AnlogicInfo/referencedesign/README.txt

Reference Design for Anlogic PLD devices.

Copyright 2011-2017 Anlogic Technologies.
