AnlogicInfo/referencedesign/eg4-20/MINI_EG4X20.pdf

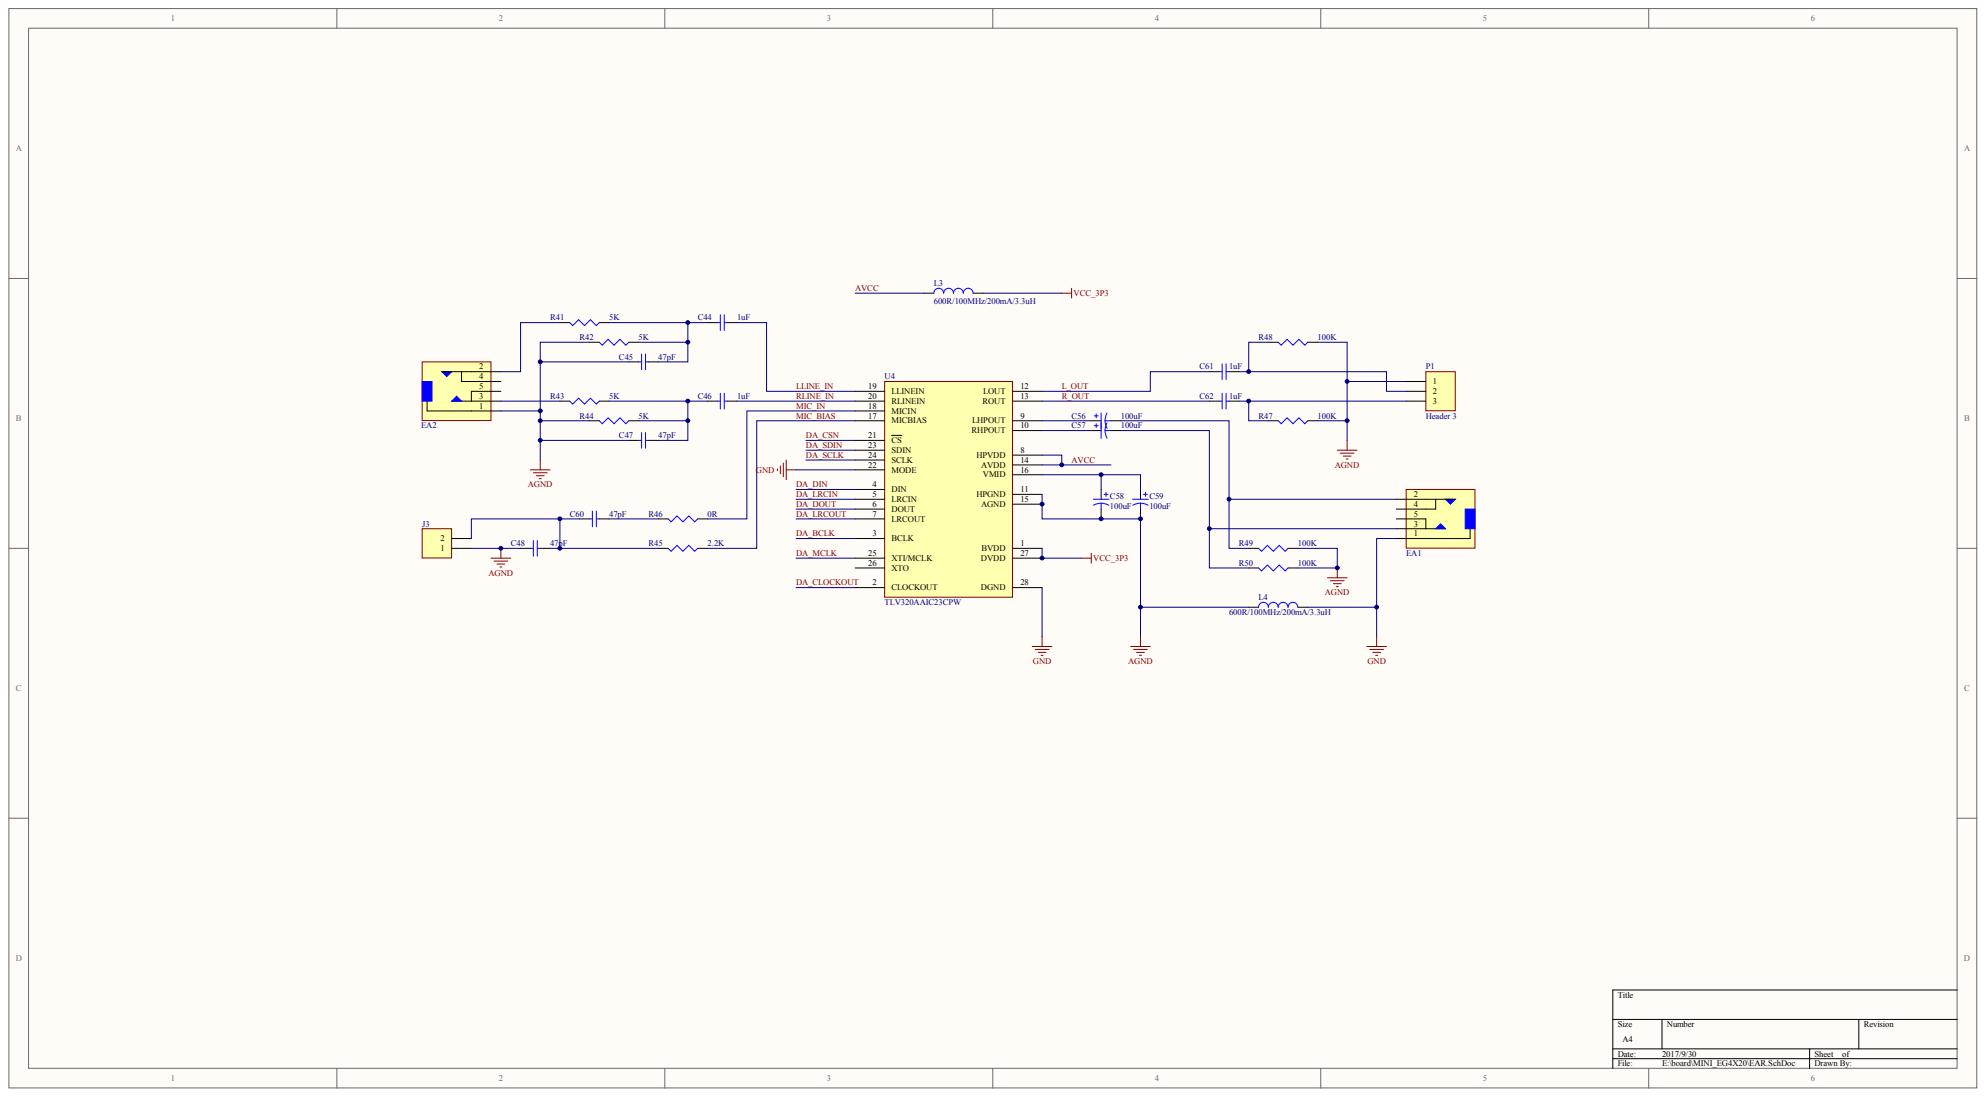
[picture p8: page 1]

1 5 1 2 7 2 8 | VCC_3P | 3 | R49

DA_BCL K 2 . 2 K | 2 6

S ize A4 | Number | Rev isi o n

Date: 2017/9/30 | S heet o f
F i le: E : \board\MINI_EG4X20 \ E AR.SchDoc | Drawn B y :

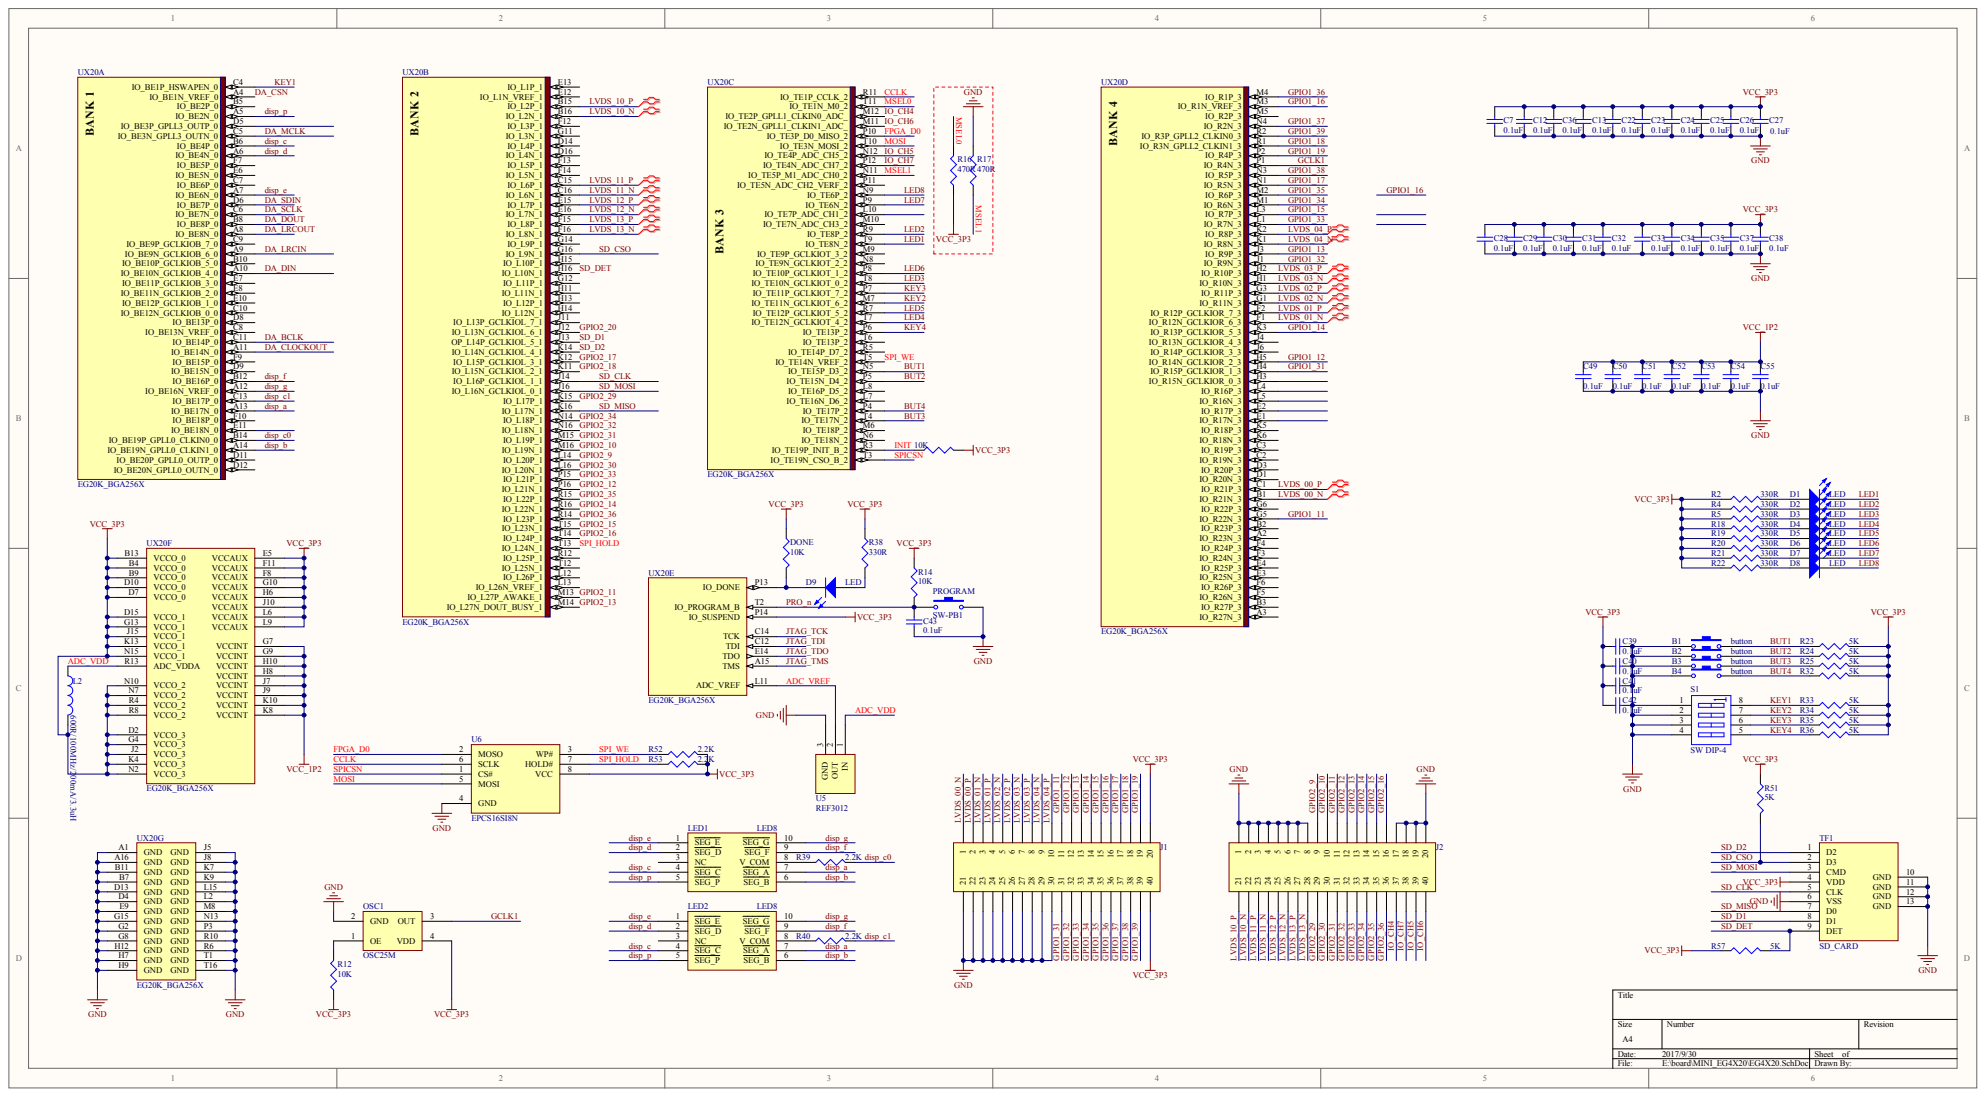
[picture p9: page 2]

Size A4 | Number | Revision

Date: 2017/9/30 | Sheet of
File: E:\board\MINI_EG4X20\EG4X20.SchDoc | Drawn By:

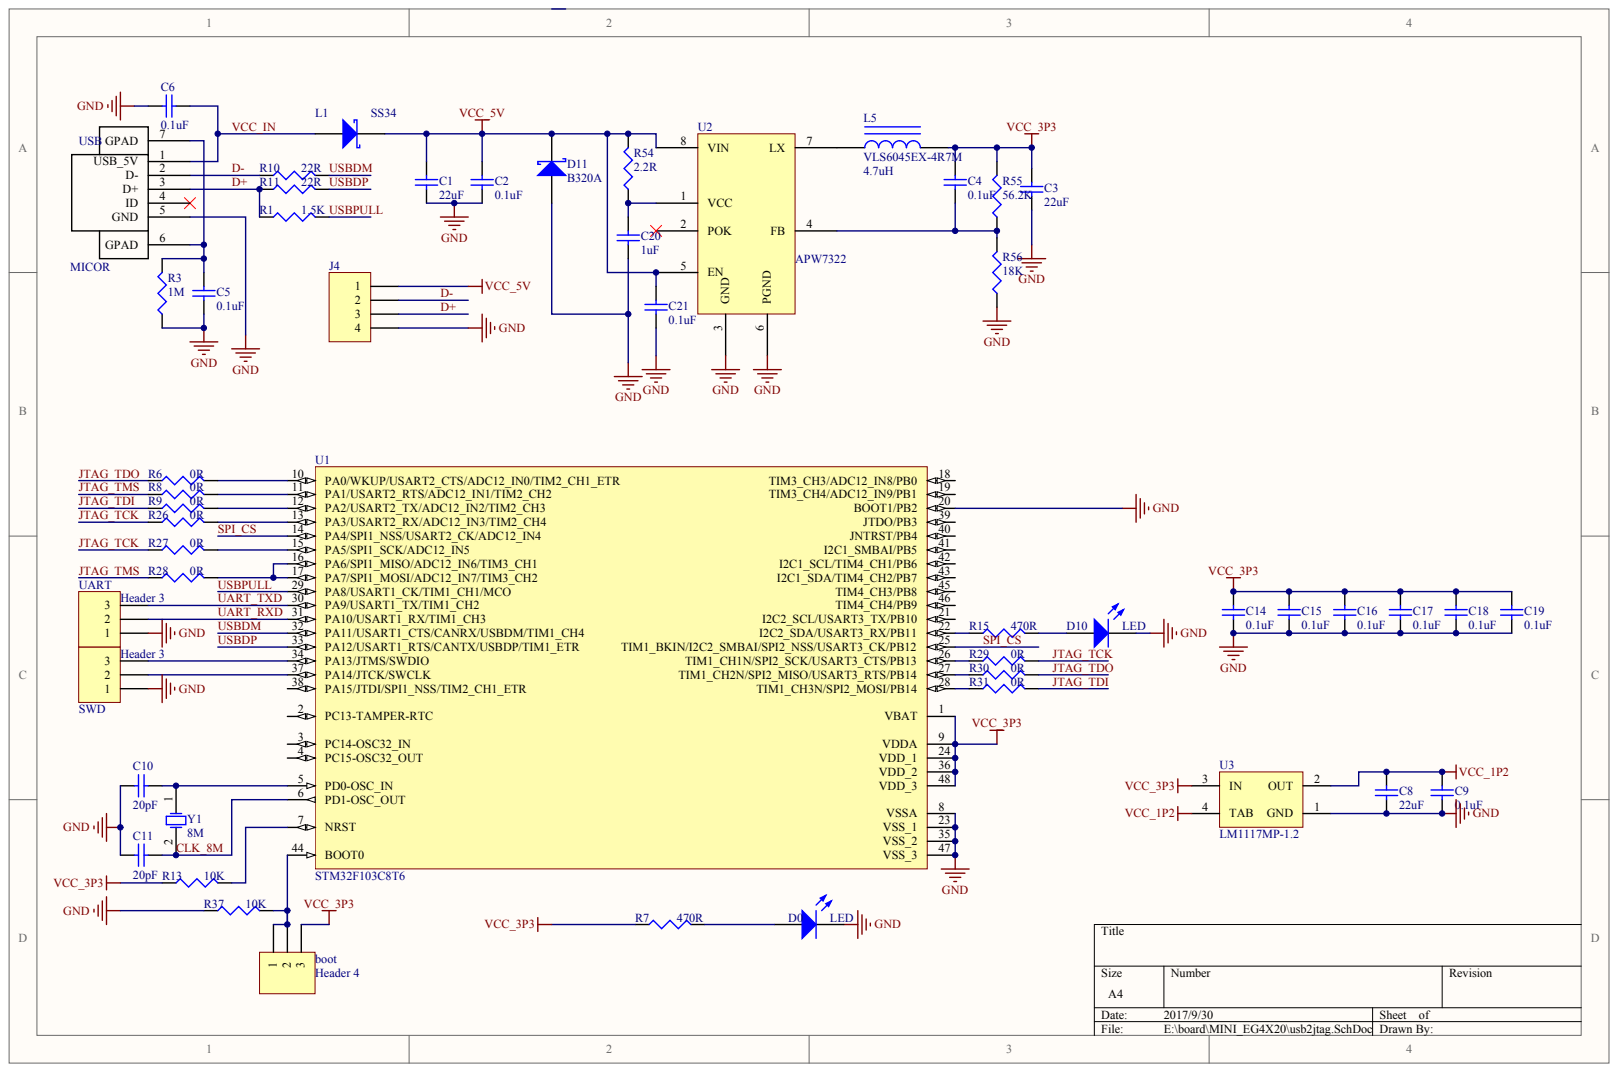
[picture p10: page 3]

PA11/USART1_CTS/CANRX/USBDM/TIM1_CH4 32

Header 3 | USBDP | PA12/USART1_RTS/CANTX/USBDP/TIM1_ETR 33
3 2 1 | | PA13/JTMS/SWDIO 34

PA15/JTDI/SPI1_NSS/TIM2_CH1_ETR 38

PD1-OSC_OUT 6

BOOT0 44

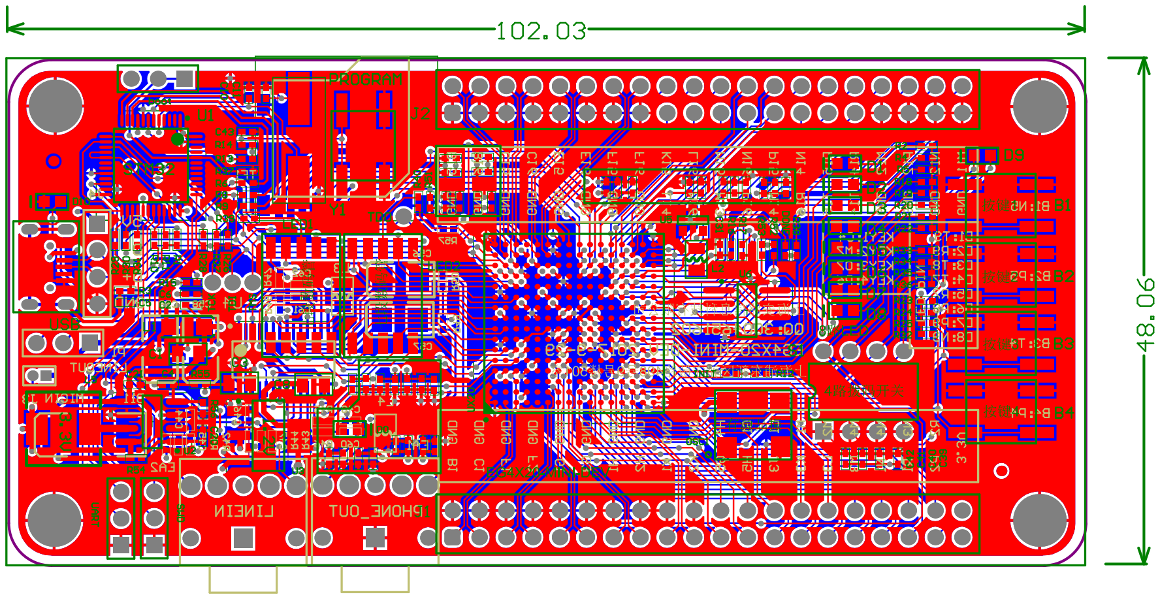
[picture p11: page 4]
