AnlogicInfo/referencedesign/al3/AL3S10LG144_CORE.PDF

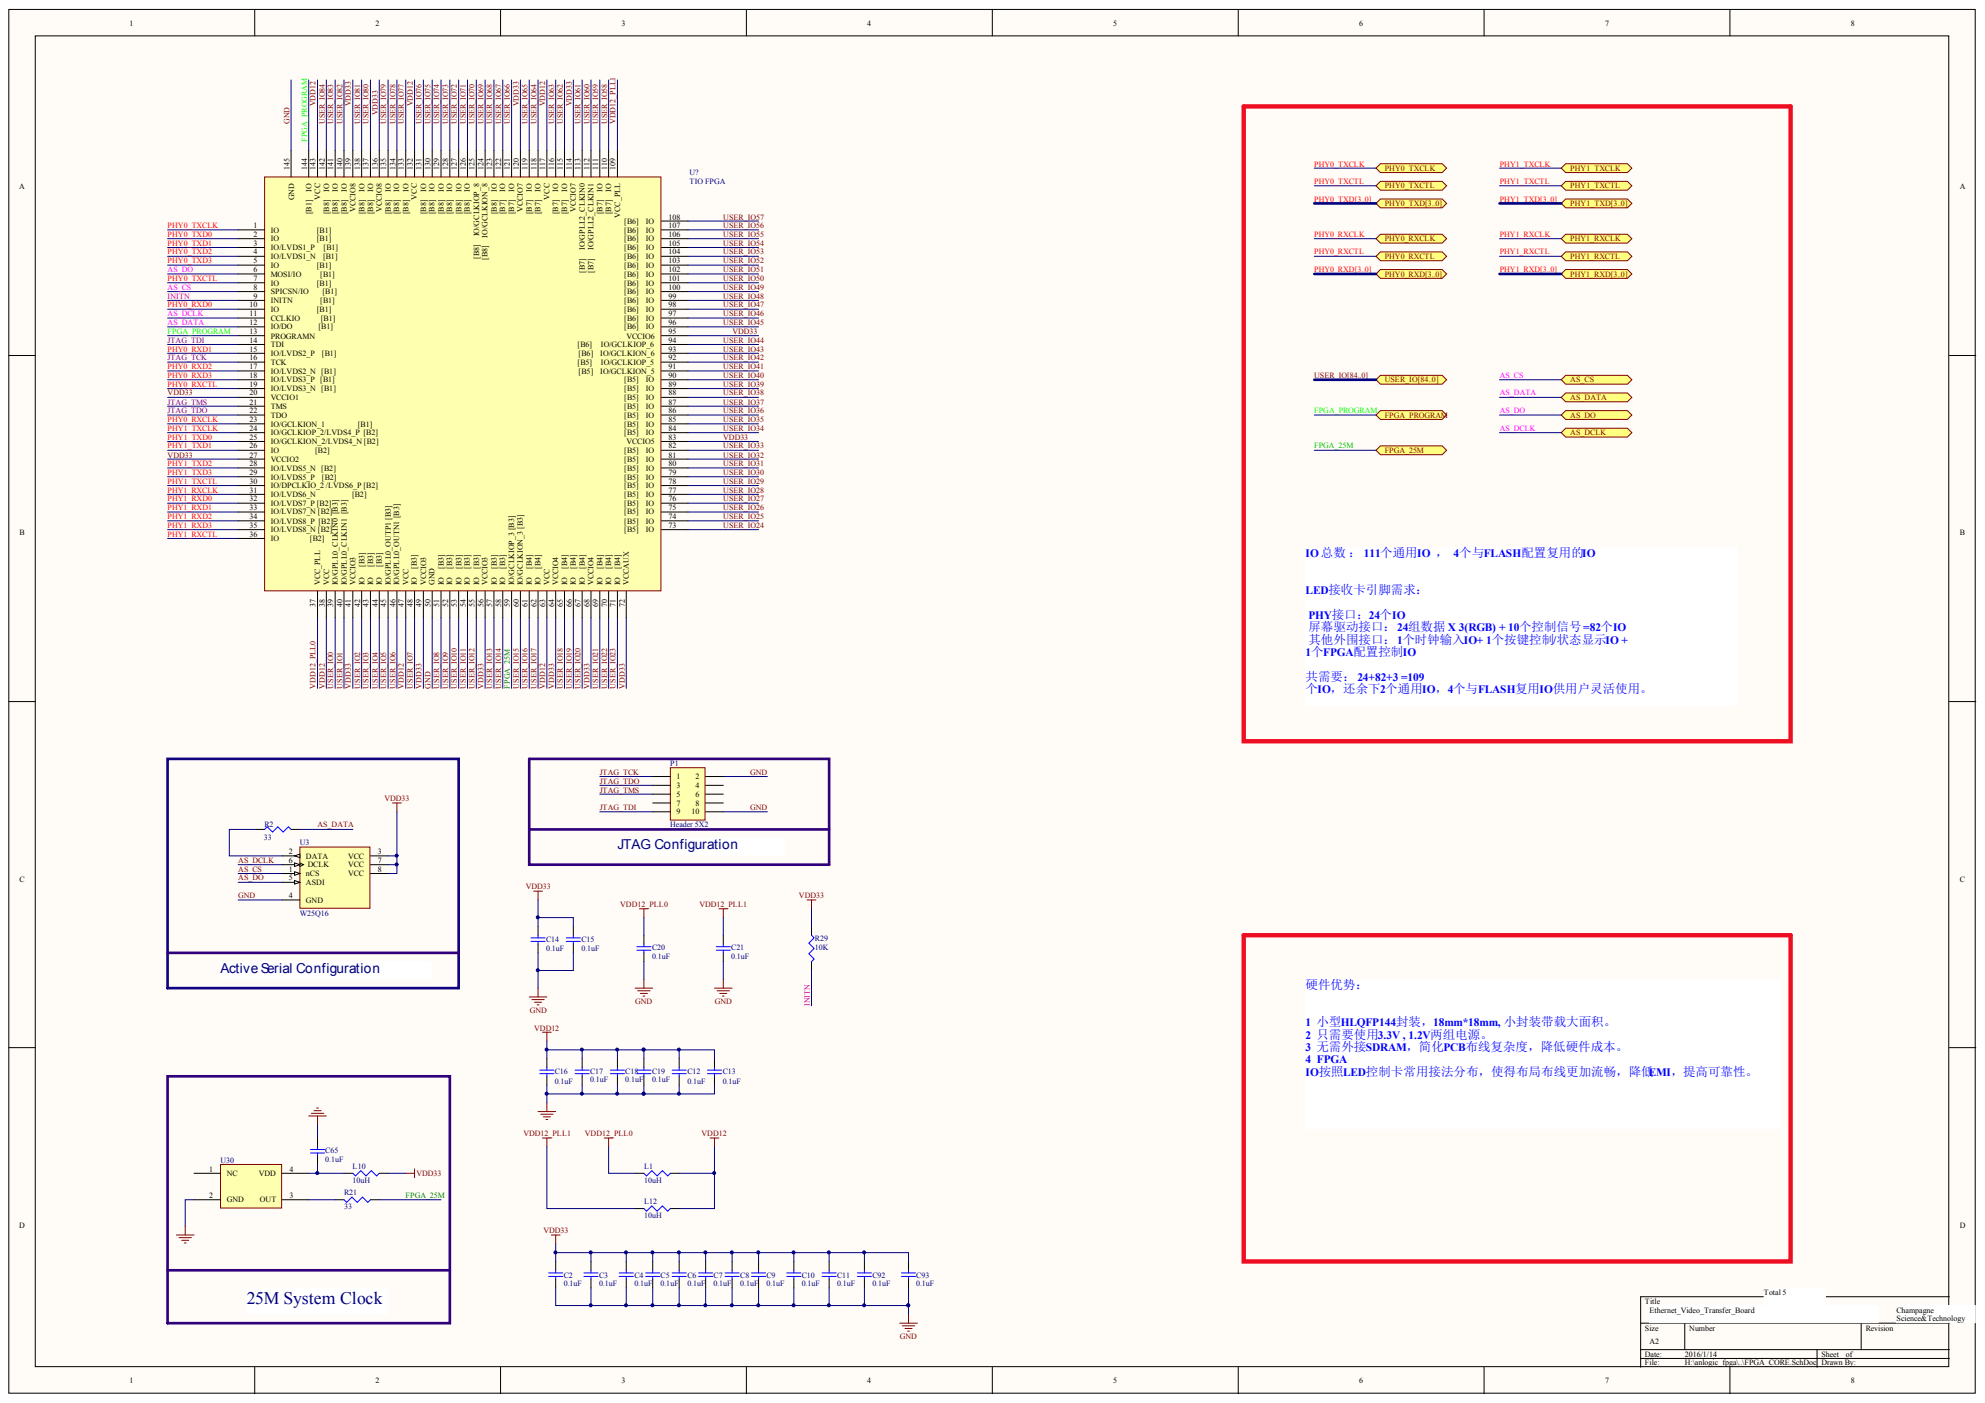
[picture p12: page 1]

[B7] IO/GPLL2_CLKIN0 113 VCCIO7 114 [B7] IO 115 [B7] IO 116 VCC 117 [B7] IO 118 [B7] IO 119 VCCIO7 120 [B7] IO 121 [B7] IO 122 [B8] IO 123 [B8] IO/GCLKION_8 124 [B8] IO/GCLKIOP_8 125 [B8] IO 126 [B8] IO 127 [B8] IO 128 [B8] IO 129 [B8] IO 130 [B8] IO 131 VCC 132 [B8] IO 133 [B8] IO 134 [B8] IO 135 VCCIO8 136 [B8] IO 137 [B8] IO 138 VCCIO8 139

VCCAUX 72 [B5] IO 73 [B5] IO 74 [B5] IO 75

3 无需外接SDRAM，简化PCB布线复杂度，降低硬件成本。 4 FPGA
IO按照LED控制卡常用接法分布，使得布局布线更加流畅，降低EMI，提高可靠性。
