AnlogicInfo/referencedesign/eg4-20/eg4duino_fin.brd

## EAGLE design eg4-20/eg4duino_fin.brd (2018-01-02)

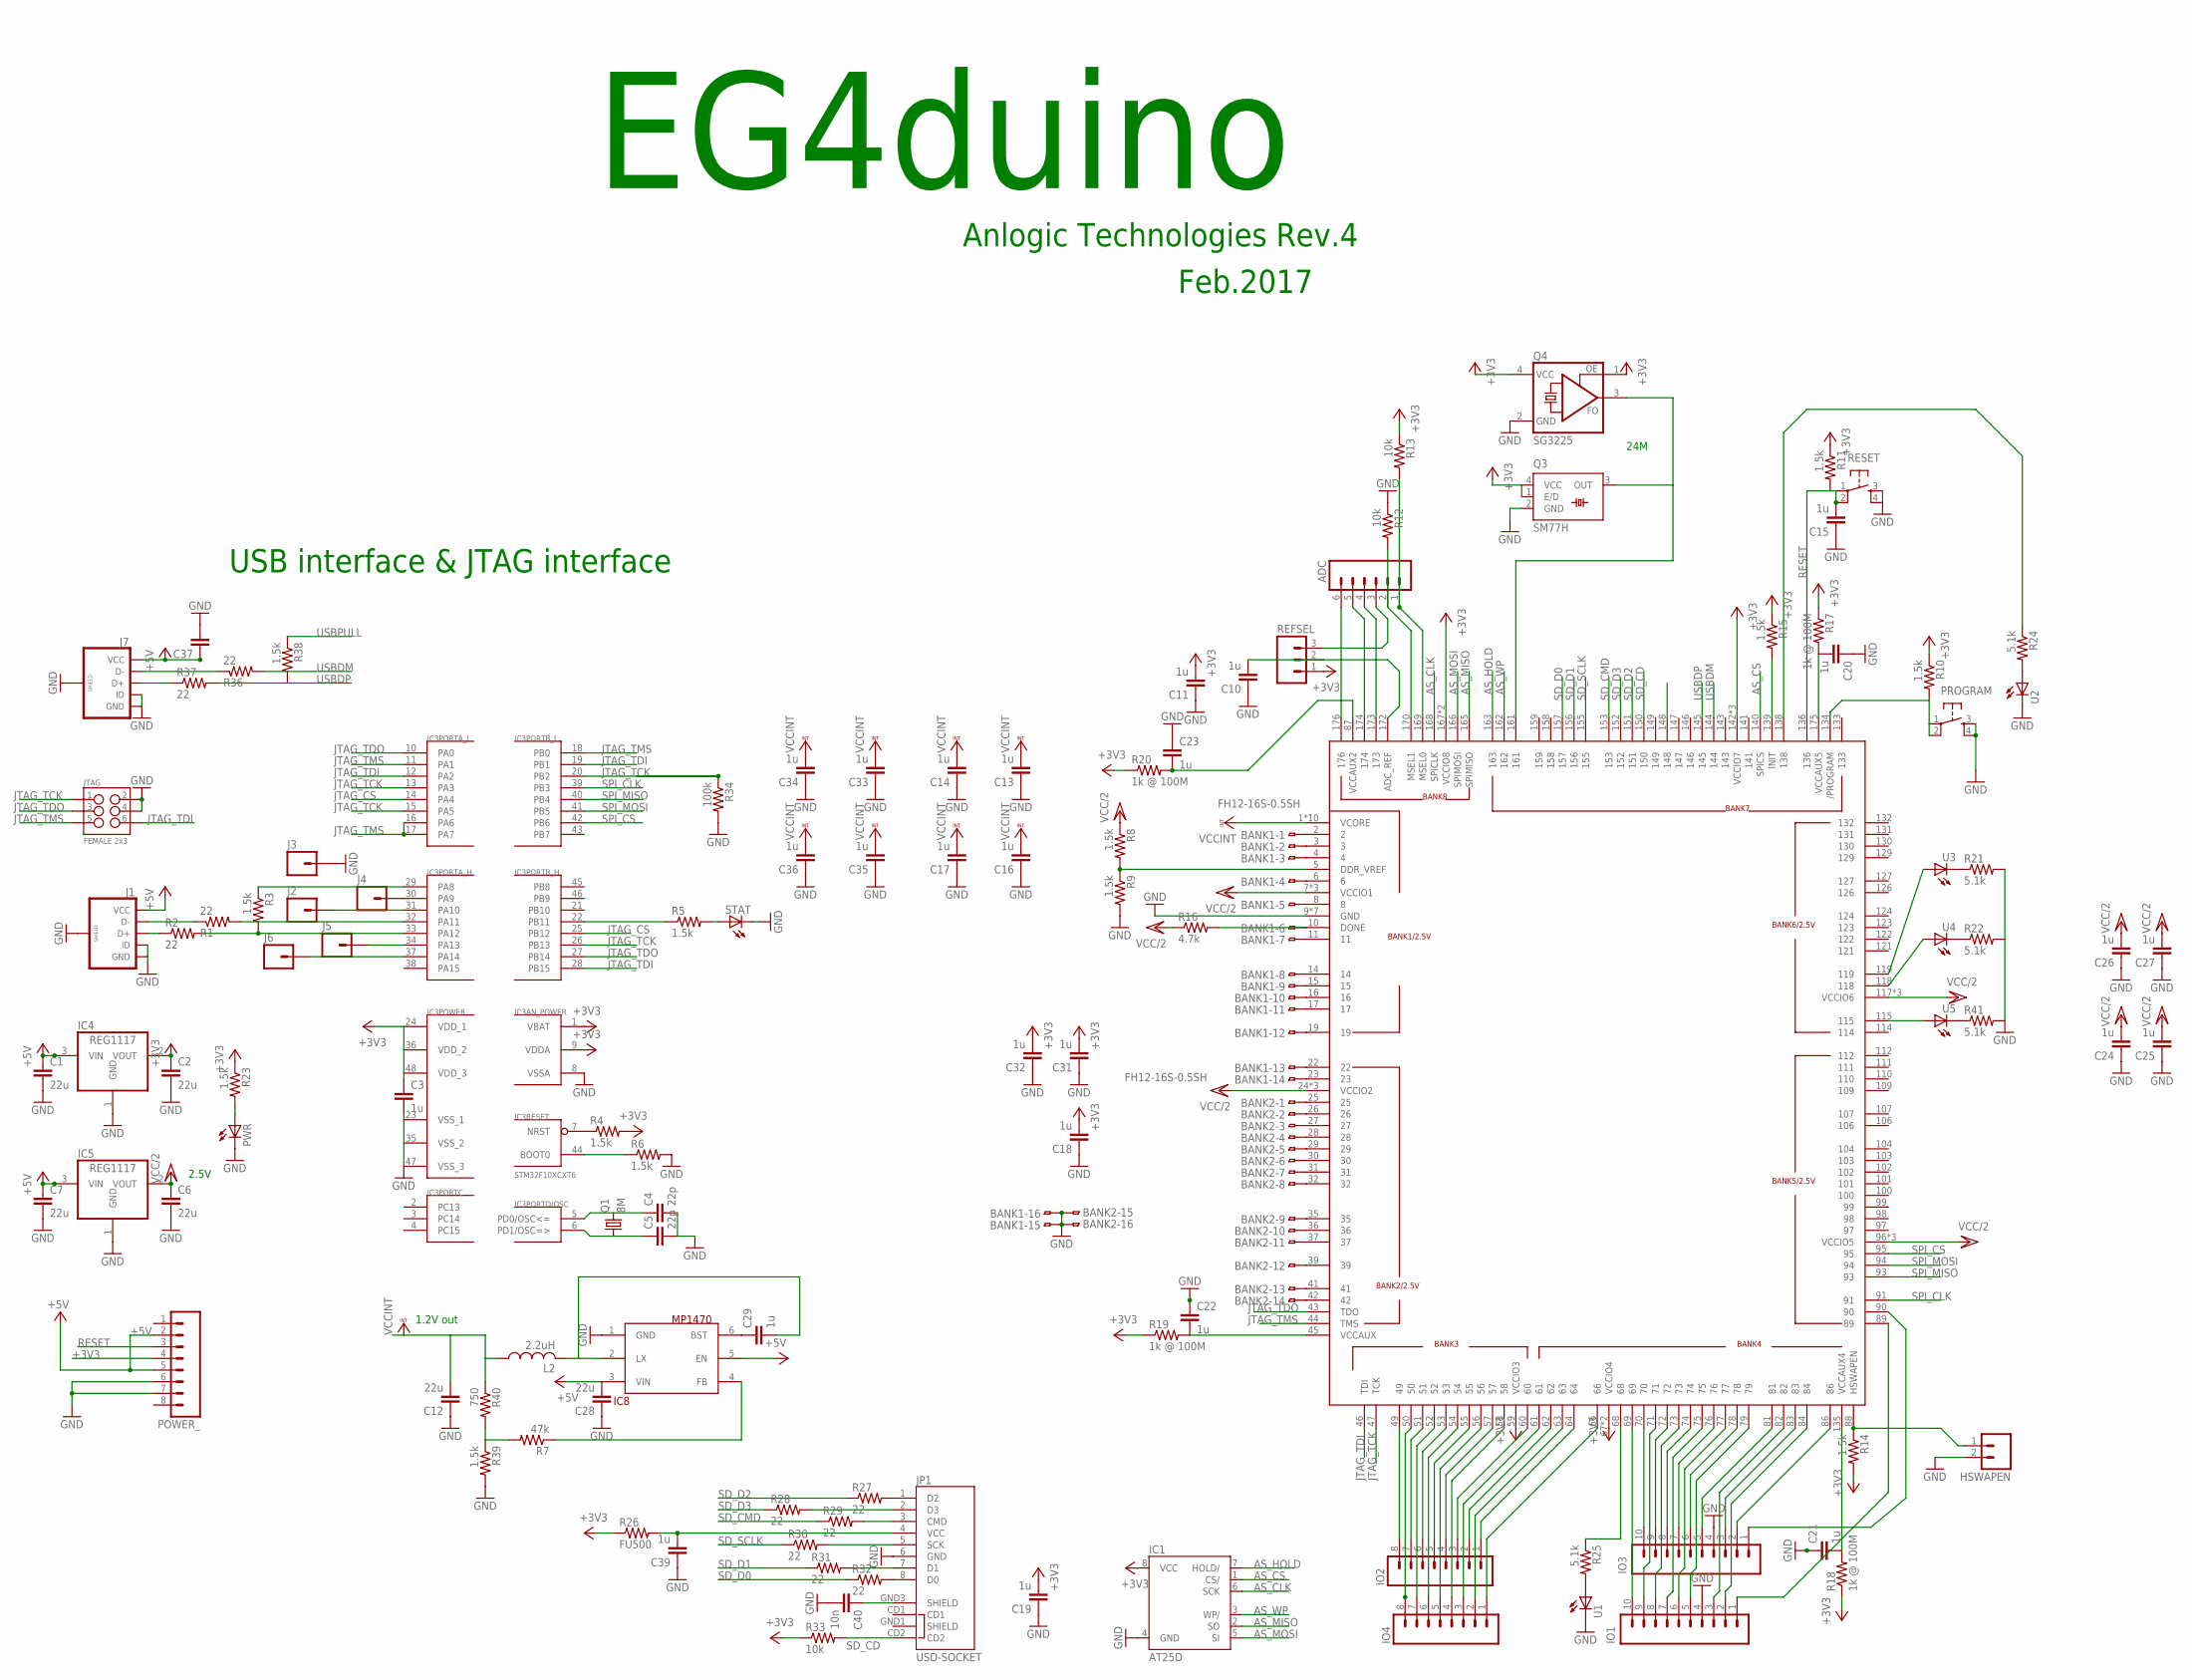
[picture p13: schematic eg4duino_fin.sch]

Parts:
ADC: M06SILK_FEMALE_PTH; 1X06
BANK1, BANK2: FH12-16S-0.5SH
C1, C2, C6, C7, C12, C28: 22u; C0805
C3, C10, C11, C13, C14, C15, C16, C17, C18, C19, C20, C21, C22, C23, C24, C25, C26, C27, C29, C31, C32, C33, C34, C35, C36, C39: 1u; C0805
C4, C5: 22p; C0805
C37: C-EUC0805; C0805
C40: 10n; C0805
HSWAPEN: M02PTH; 1X02
IC1: AT25D; SOIC8
IC2: EG4D20EG176; ELQFP176L
IC3: STM32F10XCXT6; TQFP48
IC4, IC5: REG1117; SOT223
IC8: MP1470; SOT23-6L
IO1, IO3: M10SILK_FEMALE_PTH; 1X10
IO2, IO4: M08SILK_FEMALE_PTH; 1X08
J1, J7: USB_MICROB_PLUGCONN-11752; USB-B-MICRO-SMD_V03
J2, J3, J4, J5, J6: M01; 0805SMD
JP1: USD-SOCKET; MICROSD_1:1
JTAG: FEMALE 2x3; 2X3
L2: 2.2uH; L4532P
POWER_: M08SILK_FEMALE_PTH; 1X08
PROGRAM: 10-XXSMD; B3F-10SMD
PWR: LEDCHIP-LED0805; CHIP-LED0805
Q1: 8M; HC49/S
Q3: SM77H
Q4: SG3225; 3225
R1, R2: 22; M0805
R3, R4, R5, R6, R23: 1.5k; M0805
R7: 47k; R0805
R8, R9, R11, R14, R15, R39: 1.5k; R0805
R10, R38: 1.5k; R0603
R12, R13, R33: 10k; R0805
R16: 4.7k; R0603
R17, R18, R19, R20: 1k @ 100M; R0805
R21, R22, R24, R25, R41: 5.1k; M0805
R26: FU500; R0805
R27, R28, R29, R30, R31, R32: 22; R0201
R34: 100k; R0603
R36, R37: 22; R0603W
R40: 750; R0805
REFSEL: M03PTH; 1X03
RESET: 10-XXSMD; B3F-10SMD
STAT: LEDCHIP-LED0805; CHIP-LED0805
U1, U2, U3, U4, U5: LEDCHIP-LED0805; CHIP-LED0805

Connections:
+3V3: C2.1, C3.1, C11.2, C18.2, C19.2, C31.2, C32.2, IC1.8 (VCC), IC2.59 (VCCIO3), IC2.67 (VCCIO4), IC2.80 (VCCIO4), IC2.142 (VCCIO7), IC2.154 (VCCIO7), IC2.160 (VCCIO7), IC2.167 (VCCIO8), IC2.171 (VCCIO8), IC3.1 (VBAT), IC3.9 (VDDA), IC3.24 (VDD_1), IC3.36 (VDD_2), IC3.48 (VDD_3), IC4.2 (VOUT), POWER_.4, Q3.1 (E/D), Q3.4 (VCC), Q4.1 (OE), Q4.4 (VCC), R4.2, R10.1, R11.1, R13.1, R14.2, R15.1, R17.1, R18.1, R19.1, R20.1, R23.1, R26.1, R33.1, REFSEL.1
+5V: C1.1, C7.1, C28.2, C37.1, IC4.3 (VIN), IC5.3 (VIN), IC8.3 (VIN), IC8.5 (EN), J1.VBUS (VCC), J7.VBUS (VCC), POWER_.2, POWER_.5
AS_CLK: IC1.6 (SCK), IC2.168 (SPICLK)
AS_CS: IC1.1 (CS/), IC2.140 (SPICS)
AS_HOLD: IC1.7 (HOLD/), IC2.163
AS_MISO: IC1.2 (SO), IC2.165 (SPIMISO)
AS_MOSI: IC1.5 (SI), IC2.166 (SPIMOSI)
AS_WP: IC1.3 (WP/), IC2.162
GND: BANK1.15, BANK1.16, BANK2.15, BANK2.16, C1.2, C2.2, C3.2, C4.2, C5.2, C6.2, C7.2, C10.1, C11.1, C12.1, C13.1, C14.1, C15.1, C16.1, C17.1, C18.1, C19.1, C20.1, C21.1, C22.1, C23.1, C24.1, C25.1, C26.1, C27.1, C28.1, C31.1, C32.1, C33.1, C34.1, C35.1, C36.1, C37.2, C39.1, C40.2, HSWAPEN.2, IC1.4 (GND), IC2.9 (GND), IC2.13 (GND), IC2.21 (GND), IC2.33 (GND), IC2.38 (GND), IC2.116 (GND), IC2.EGND (GND), IC3.8 (VSSA), IC3.23 (VSS_1), IC3.35 (VSS_2), IC3.47 (VSS_3), IC4.1 (GND), IC5.1 (GND), IC8.1 (GND), IO1.4, IO3.4, J1.GND, J1.ID, J1.SHIELD1 (SHIELD), J1.SHIELD2 (SHIELD), J1.SHIELD3 (SHIELD), J3.1, J7.GND, J7.ID, J7.SHIELD1 (SHIELD), J7.SHIELD2 (SHIELD), J7.SHIELD3 (SHIELD), JP1.6 (GND), JTAG.2, JTAG.4, POWER_.6, POWER_.7, PROGRAM.3 (S), PROGRAM.4 (S1), PWR.C, Q3.2 (GND), Q4.2 (GND), R6.2, R9.2, R12.1, R21.2, R22.2, R34.2, R39.2, R41.2, RESET.3 (S), RESET.4 (S1), STAT.C, U1.C, U2.C
JTAG_CS: IC3.14 (PA4), IC3.25 (PB12)
JTAG_TCK: IC2.47 (TCK), IC3.13 (PA3), IC3.15 (PA5), IC3.20 (PB2), IC3.26 (PB13), JTAG.1, R34.1
JTAG_TDI: IC2.46 (TDI), IC3.12 (PA2), IC3.19 (PB1), IC3.28 (PB15), JTAG.6
JTAG_TDO: IC2.43 (TDO), IC3.10 (PA0), IC3.27 (PB14), JTAG.3
JTAG_TMS: IC2.44 (TMS), IC3.11 (PA1), IC3.16 (PA6), IC3.17 (PA7), IC3.18 (PB0), JTAG.5
unnamed: ADC.6, IC2.176
unnamed: ADC.5, IC2.174
unnamed: ADC.4, IC2.173
unnamed: ADC.3, REFSEL.3
unnamed: ADC.2, IC2.170 (MSEL1), R12.2
unnamed: ADC.1, IC2.169 (MSEL0), R13.2
unnamed: IC2.69, IO1.10
unnamed: IC2.70, IO3.10
unnamed: IC2.71, IO1.9
unnamed: IC2.72, IO3.9
unnamed: IC2.73, IO1.8
unnamed: IC2.74, IO3.8
unnamed: IC2.75, IO1.7
unnamed: IC2.76, IO3.7
unnamed: IC2.77, IO1.6
unnamed: IC2.78, IO3.6
unnamed: IC2.79, IO1.5
unnamed: IC2.83, IO3.3
unnamed: IC2.81, IO3.5
unnamed: IC2.82, IO1.3
unnamed: IC2.84, IO1.2
unnamed: IC2.86, IO3.2
unnamed: IC2.89, IO1.1
unnamed: IC2.90, IO3.1
unnamed: J1.D+, R2.1
unnamed: J1.D-, R1.1
unnamed: IC3.32 (PA11), R1.2
unnamed: IC3.33 (PA12), R2.2, R3.2
unnamed: IC3.29 (PA8), R3.1
unnamed: IC3.31 (PA10), J2.1
unnamed: IC3.30 (PA9), J4.1
unnamed: IC3.7 (NRST), R4.1
unnamed: IC3.22 (PB11), R5.1
unnamed: R5.2, STAT.A
unnamed: C4.1, IC3.5 (PD0/OSC<=), Q1.2
unnamed: C5.1, IC3.6 (PD1/OSC=>), Q1.1
unnamed: IC3.44 (BOOT0), R6.1
unnamed: IC2.49, IO2.8
unnamed: IC2.51, IO2.7
unnamed: IC2.53, IO2.6
unnamed: IC2.54, IO4.6
unnamed: IC2.55, IO2.5
unnamed: IC2.56, IO4.5
unnamed: IC2.57, IO2.4
unnamed: IC2.58, IO4.4
unnamed: IC2.60, IO2.3
unnamed: IC2.61, IO4.3
unnamed: IC2.62, IO2.2
unnamed: IC2.63, IO4.2
unnamed: IC2.64, IO2.1
unnamed: IC2.66, IO4.1
unnamed: IC2.161, Q3.3 (OUT), Q4.3 (FO)
unnamed: C10.2, IC2.172 (ADC_REF), REFSEL.2
unnamed: IC2.119, U3.A
unnamed: IC2.118, U4.A
unnamed: C29.2, IC8.2 (LX), L2.2
unnamed: C29.1, IC8.6 (BST)
unnamed: IC8.4 (FB), R7.1
unnamed: R7.2, R39.1, R40.2
unnamed: IC2.5 (DDR_VREF), R8.2, R9.1
unnamed: BANK1.1, IC2.2
unnamed: BANK1.2, IC2.3
unnamed: BANK1.3, IC2.4
unnamed: BANK1.4, IC2.6
unnamed: BANK1.5, IC2.8
unnamed: IC3.34 (PA13), J5.1
unnamed: BANK1.7, IC2.11
unnamed: BANK1.8, IC2.14
unnamed: BANK1.9, IC2.15
unnamed: BANK1.10, IC2.16
unnamed: BANK1.11, IC2.17
unnamed: BANK1.12, IC2.19
unnamed: BANK1.13, IC2.22
unnamed: BANK1.14, IC2.23
unnamed: BANK2.1, IC2.25
unnamed: BANK2.2, IC2.26
unnamed: BANK2.3, IC2.27
unnamed: BANK2.4, IC2.28
unnamed: BANK2.5, IC2.29
unnamed: BANK2.6, IC2.30
unnamed: BANK2.7, IC2.31
unnamed: BANK2.8, IC2.32
unnamed: BANK2.9, IC2.35
unnamed: BANK2.10, IC2.36
unnamed: BANK2.11, IC2.37
unnamed: BANK2.12, IC2.39
unnamed: BANK2.13, IC2.41
unnamed: BANK2.14, IC2.42
unnamed: C20.2, IC2.175 (VCCAUX5), R17.2
unnamed: HSWAPEN.1, IC2.88 (HSWAPEN), R14.1
unnamed: IC2.139 (INIT), R15.2
unnamed: C21.2, IC2.135 (VCCAUX4), R18.2
unnamed: C22.2, IC2.45 (VCCAUX), R19.2
unnamed: C23.2, IC2.87 (VCCAUX2), R20.2
unnamed: IC2.115, U5.A
unnamed: PWR.A, R23.2
unnamed: R24.2, U2.A
unnamed: IC2.138, R24.1
unnamed: R25.2, U1.A
unnamed: IC2.68, R25.1
unnamed: C39.2, JP1.4 (VCC), R26.2
unnamed: JP1.1 (D2), R27.2
unnamed: IC2.134 (/PROGRAM), PROGRAM.1, PROGRAM.2 (P1), R10.2
unnamed: JP1.2 (D3), R28.2
unnamed: JP1.3 (CMD), R29.2
unnamed: JP1.8 (D0), R32.2
unnamed: JP1.7 (D1), R31.2
unnamed: IC3.37 (PA14), J6.1
unnamed: JP1.5 (SCK), R30.2
unnamed: C40.1, JP1.GND3 (SHIELD)
unnamed: BANK1.6, IC2.10 (DONE), R16.2
unnamed: J7.D-, R36.1
unnamed: J7.D+, R37.1
unnamed: R21.1, U3.C
unnamed: R22.1, U4.C
unnamed: R41.1, U5.C
RESET: C15.2, IC2.136, POWER_.3, R11.2, RESET.1, RESET.2 (P1)
SD_CD: IC2.150, JP1.CD2, R33.2
SD_CMD: IC2.153, R29.1
SD_D0: IC2.157, R32.1
SD_D1: IC2.156, R31.1
SD_D2: IC2.151, R27.1
SD_D3: IC2.152, R28.1
SD_SCLK: IC2.155, R30.1
SPI_CLK: IC2.91, IC3.39 (PB3)
SPI_CS: IC2.95, IC3.42 (PB6)
SPI_MISO: IC2.93, IC3.40 (PB4)
SPI_MOSI: IC2.94, IC3.41 (PB5)
USBDM: IC2.144, R36.2
USBDP: IC2.145, R37.2, R38.2
USBPULL: IC2.148, R38.1
USER_RX: IC2.52, IO4.7
USER_TX: IC2.50, IO4.8
VCC/2: C6.1, C24.2, C25.2, C26.2, C27.2, IC2.7 (VCCIO1), IC2.12 (VCCIO1), IC2.18 (VCCIO1), IC2.24 (VCCIO2), IC2.34 (VCCIO2), IC2.40 (VCCIO2), IC2.96 (VCCIO5), IC2.105 (VCCIO5), IC2.108 (VCCIO5), IC2.117 (VCCIO6), IC2.120 (VCCIO6), IC2.125 (VCCIO6), IC5.2 (VOUT), R8.1, R16.1
VCCINT: C12.2, C13.2, C14.2, C16.2, C17.2, C33.2, C34.2, C35.2, C36.2, IC2.1 (VCORE), IC2.20 (VCORE), IC2.48 (VCORE), IC2.65 (VCORE), IC2.85 (VCORE), IC2.92 (VCORE), IC2.113 (VCORE), IC2.128 (VCORE), IC2.137 (VCORE), IC2.164 (VCORE), L2.1, R40.1

Notes on the sheet:
1.2V out
2.5V
EG4duino
Anlogic Technologies Rev.4
Feb.2017
USB interface & JTAG interface
24M

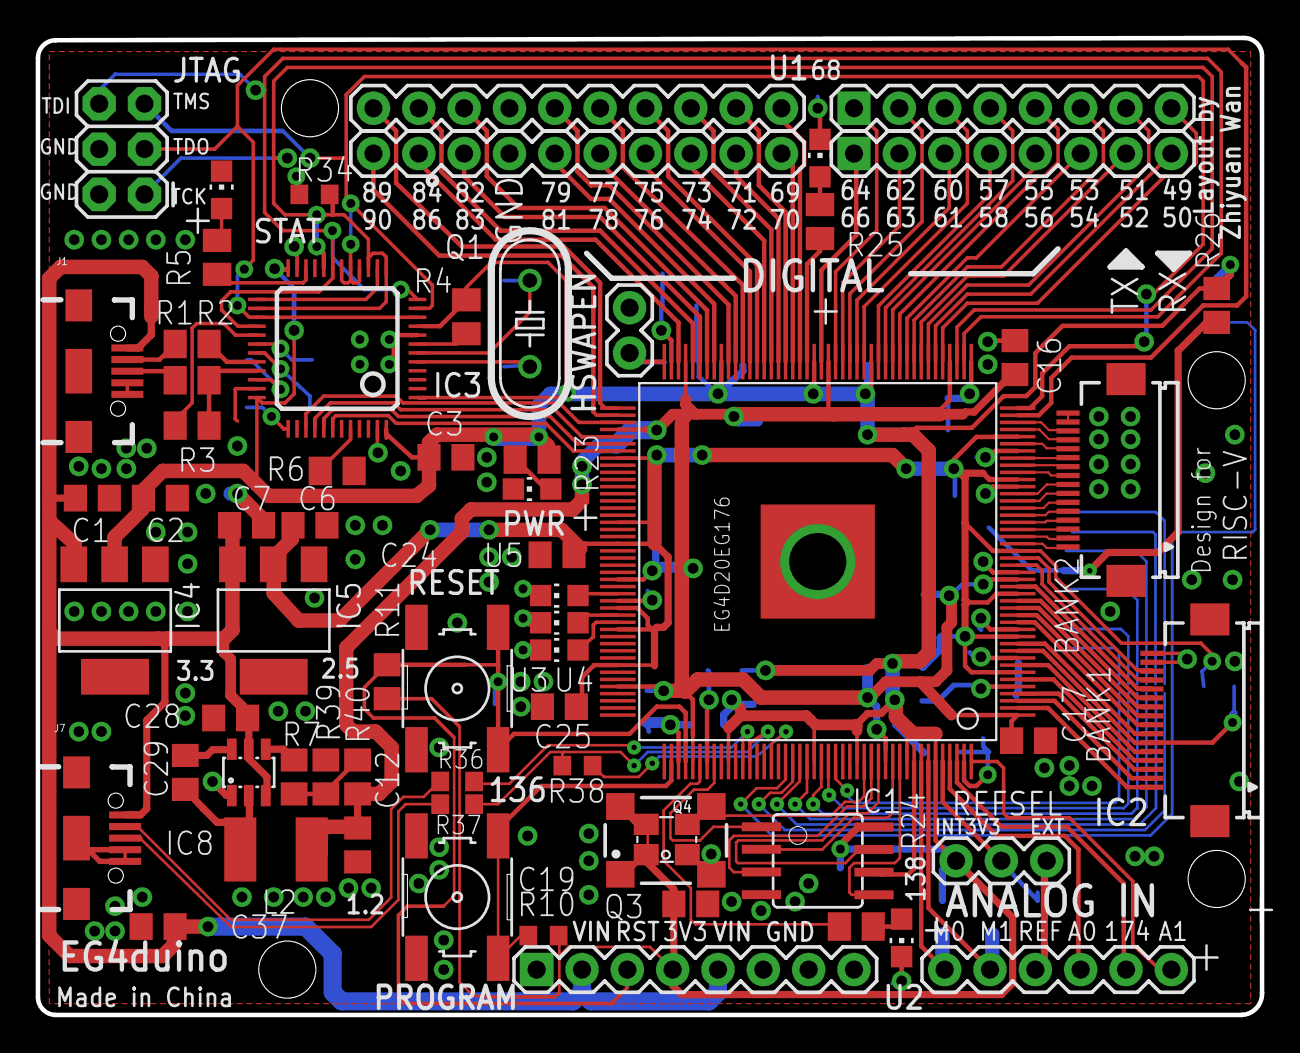
[picture p14: board eg4duino_fin.brd from above]

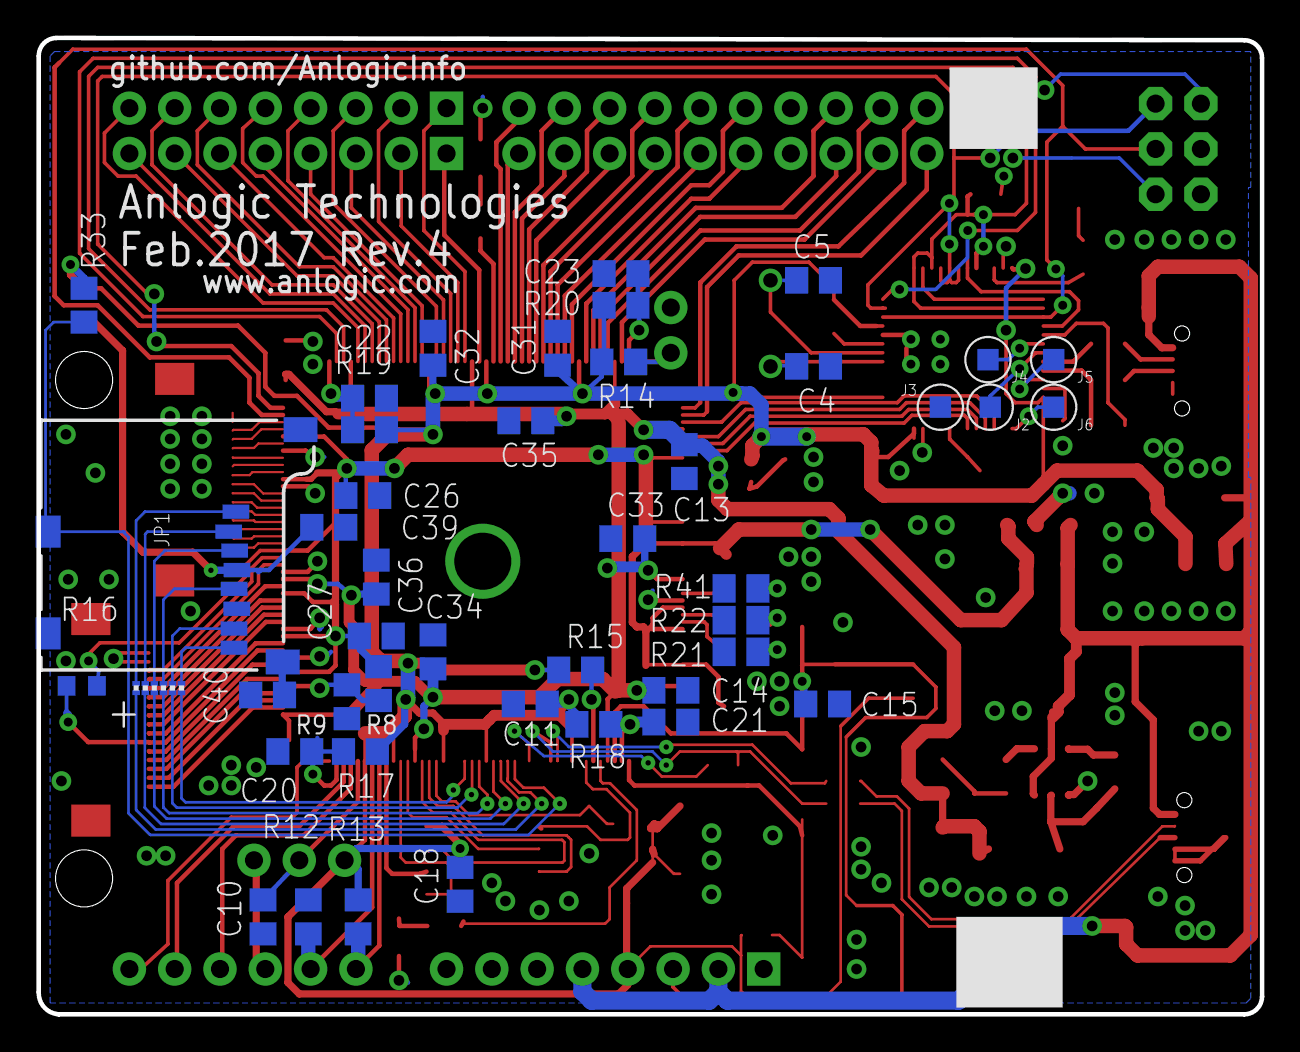
[picture p15: board eg4duino_fin.brd from below]

Board: 2 copper layers, 68.6 x 54.7 mm, 114 parts (49 on the bottom side), 149 nets.
