AnlogicInfo/referencedesign/al3/al3lg.brd

## EAGLE design al3/al3lg.brd (2018-01-02)

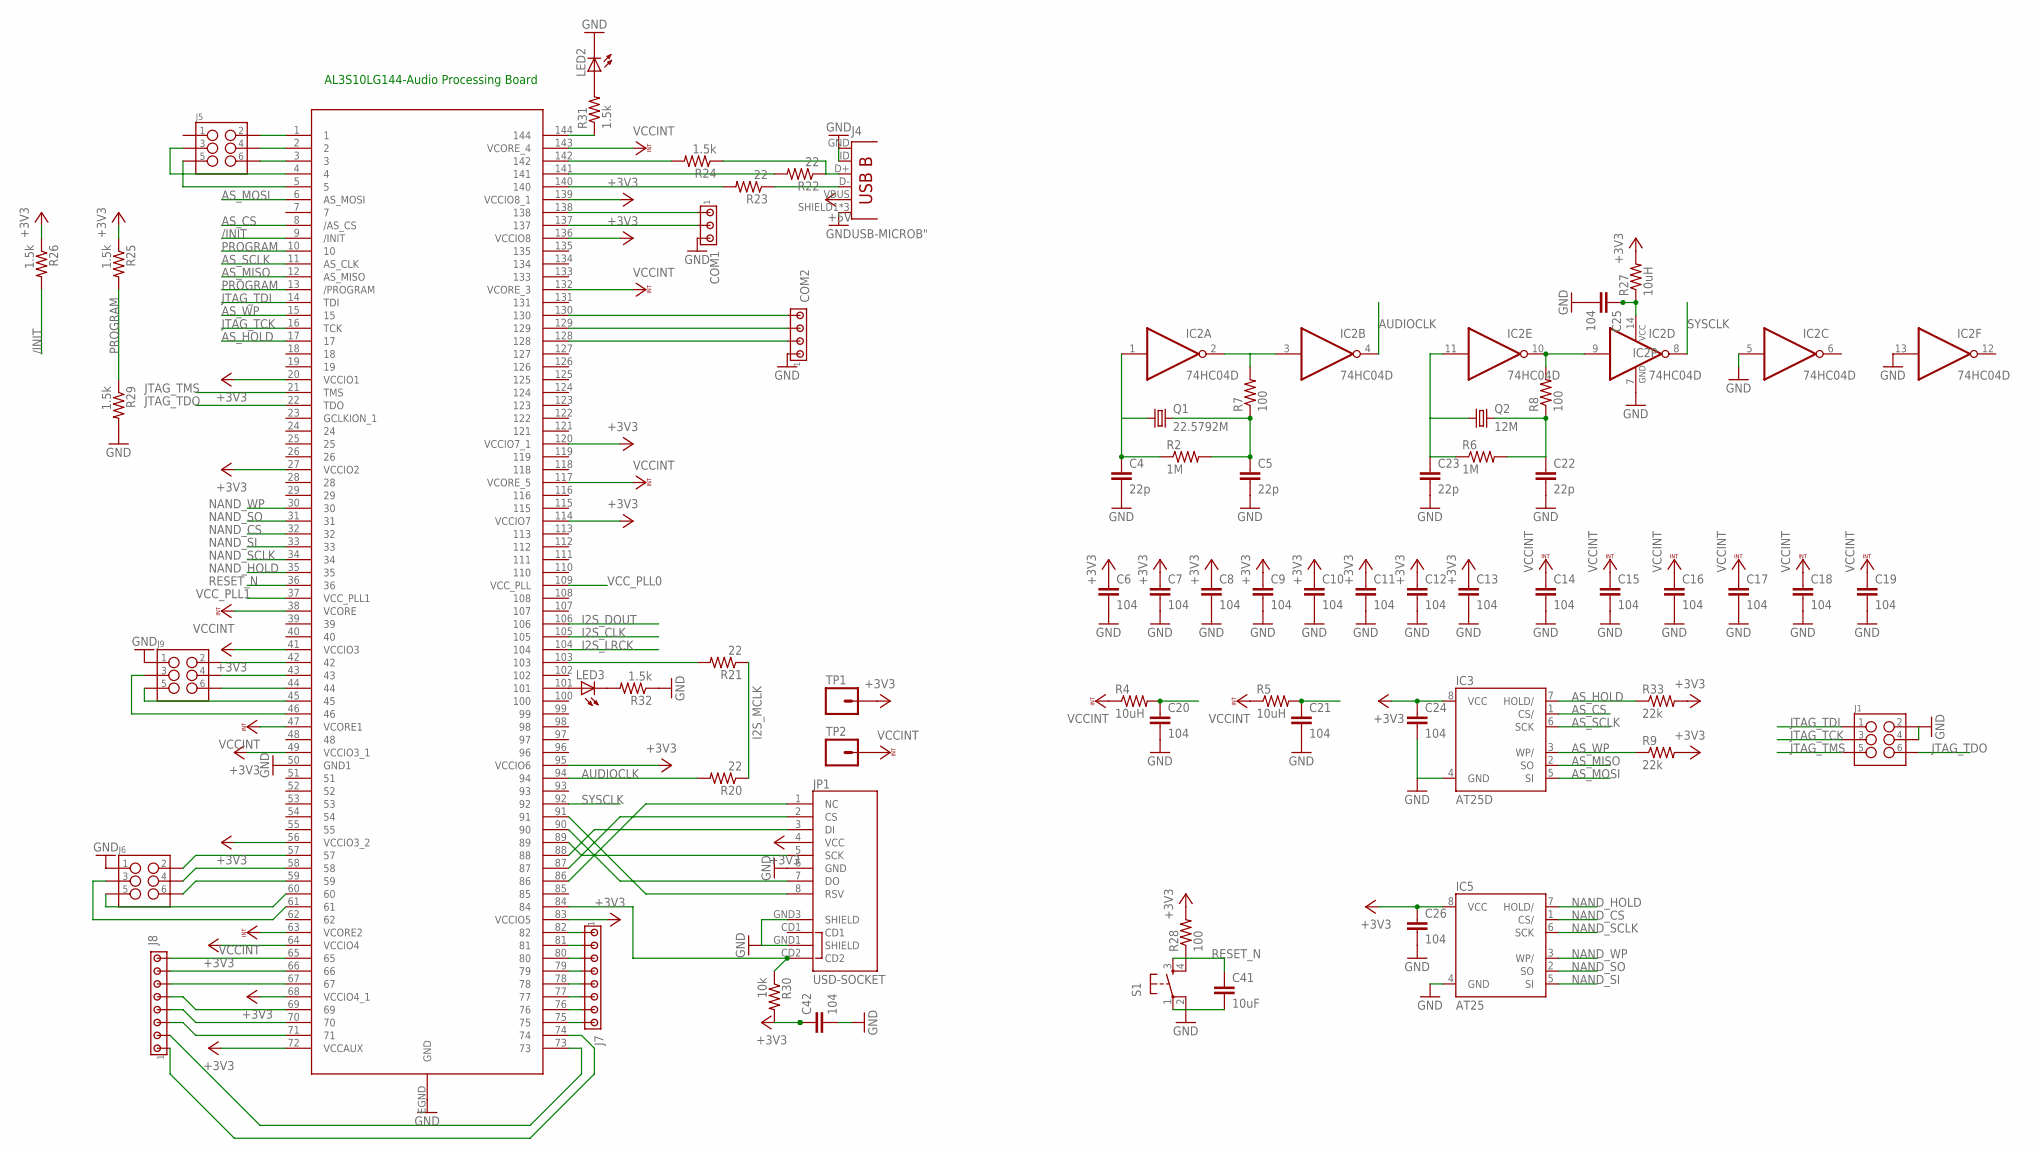
[picture p16: schematic al3lg.sch, sheet 1]

Parts:
C4, C5, C22, C23: 22p; C0805
C6, C7, C8, C9, C10, C11, C12, C13, C14, C15, C16, C17, C18, C19, C20, C21, C24, C25, C26, C42: 104; C0805
C41: 10uF; C0805
COM1: MTA03-100; 10X03MTA
COM2: MTA04-100; 10X04MTA
IC2: 74HC04D; SO14
IC3: AT25D; SOIC8
IC5: AT25; WSON8
J1, J5, J6, J9: M03X22X3_SILK_MALE_PTH; 2X3
J4: USB-MICROB"; USB-B-MICRO-SMD_V03
J7, J8: MTA08-100; 10X08MTA
JP1: USD-SOCKET; MICROSD_1:1
LED2, LED3: LEDSML0805; SML0805
Q1: 22.5792M; HC49/S
Q2: 12M; HC49/S
R2, R6: 1M; M0805
R4, R5, R27: 10uH; M0805
R7, R8, R28: 100; M0805
R9, R33: 22k; M0805
R20, R21, R22, R23: 22; M0805
R24, R25, R26, R29: 1.5k; M0805
R30: 10k; M0805
R31, R32: 1.5k; R0805
S1: 10-XXSMD; B3F-10SMD
TP1, TP2: M01; 0805SMD
U1: AL3S10LG144; HLQFP144NT16

Connections:
+3V3: C6.1, C7.1, C8.1, C9.1, C10.1, C11.1, C12.1, C13.1, C24.1, C26.1, C42.1, IC3.8 (VCC), IC5.8 (VCC), JP1.4 (VCC), R9.2, R25.1, R26.1, R27.2, R28.2, R30.2, R33.2, TP1.1, U1.20 (VCCIO1), U1.27 (VCCIO2), U1.41 (VCCIO3), U1.49 (VCCIO3_1), U1.56 (VCCIO3_2), U1.64 (VCCIO4), U1.68 (VCCIO4_1), U1.72 (VCCAUX), U1.83 (VCCIO5), U1.95 (VCCIO6), U1.114 (VCCIO7), U1.120 (VCCIO7_1), U1.136 (VCCIO8), U1.139 (VCCIO8_1); also elsewhere on the board
+5V: J4.VBUS; also elsewhere on the board
/INIT: R26.2, U1.9 (/INIT)
AS_CS: IC3.1 (CS/), U1.8 (/AS_CS)
AS_HOLD: IC3.7 (HOLD/), R33.1, U1.17
AS_MISO: IC3.2 (SO), U1.12 (AS_MISO)
AS_MOSI: IC3.5 (SI), U1.6 (AS_MOSI)
AS_SCLK: IC3.6 (SCK), U1.11 (AS_CLK)
AS_WP: IC3.3 (WP/), R9.1, U1.15
AUDIOCLK: IC2.4 (O), R20.2, U1.94
DI: J6.4, U1.58
DI1: J9.4, U1.43
DO: J6.2, U1.57
DO1: J9.2, U1.42
GND: C4.2, C5.2, C6.2, C7.2, C8.2, C9.2, C10.2, C11.2, C12.2, C13.2, C14.2, C15.2, C16.2, C17.2, C18.2, C19.2, C20.2, C21.2, C22.2, C23.2, C24.2, C25.2, C26.2, C41.2, C42.2, COM1.3, COM2.1, IC2.5 (I), IC2.7 (GND), IC2.13 (I), IC3.4 (GND), IC5.4 (GND), J1.2, J1.4, J4.GND, J4.ID (USBID), J4.SHIELD1 (SHIELD), J4.SHIELD2 (SHIELD), J4.SHIELD3 (SHIELD), J6.1, J9.1, JP1.6 (GND), JP1.GND1 (SHIELD), JP1.GND3 (SHIELD), LED2.C, R29.2, R32.1, S1.1, S1.2 (P1), U1.50 (GND1), U1.EGND (GND); also elsewhere on the board
I2S_CLK: U1.105; also elsewhere on the board
I2S_DOUT: U1.106; also elsewhere on the board
I2S_LRCK: U1.104; also elsewhere on the board
I2S_MCLK: R20.1, R21.1; also elsewhere on the board
JTAG_TCK: J1.3, U1.16 (TCK)
JTAG_TDI: J1.1, U1.14 (TDI)
JTAG_TDO: J1.6, U1.22 (TDO)
JTAG_TMS: J1.5, U1.21 (TMS)
LRCLK: J6.6, U1.59
LRCLK1: J9.6, U1.44
MCLK: J6.5, U1.60
MCLK1: J9.5, U1.45
unnamed: C4.1, IC2.1 (I), Q1.1, R2.1
unnamed: C5.1, Q1.2, R2.2, R7.1
unnamed: C23.1, IC2.11 (I), Q2.1, R6.1
unnamed: IC2.2 (O), IC2.3 (I), R7.2
unnamed: C22.1, Q2.2, R6.2, R8.1
unnamed: IC2.9 (I), IC2.10 (O), R8.2
unnamed: R21.2, U1.103
unnamed: R24.2, U1.142
unnamed: J4.D+, R22.1, R24.1
unnamed: R22.2, U1.141
unnamed: R23.2, U1.140
unnamed: J4.D-, R23.1
unnamed: COM1.1, U1.138
unnamed: COM1.2, U1.137
unnamed: C25.1, IC2.14 (VCC), R27.1
unnamed: J8.8, U1.65
unnamed: J8.7, U1.66
unnamed: J8.6, U1.67
unnamed: J8.2, U1.73
unnamed: J8.5, U1.69
unnamed: J8.4, U1.70
unnamed: J8.3, U1.71
unnamed: J8.1, U1.74
unnamed: J7.1, U1.82
unnamed: J7.2, U1.81
unnamed: J7.3, U1.80
unnamed: J7.4, U1.79
unnamed: J7.5, U1.78
unnamed: J7.6, U1.77
unnamed: J7.7, U1.76
unnamed: JP1.CD2, R30.1, U1.84
unnamed: JP1.8 (RSV), U1.91
unnamed: JP1.7 (DO), U1.90
unnamed: JP1.5 (SCK), U1.89
unnamed: JP1.3 (DI), U1.88
unnamed: JP1.2 (CS), U1.87
unnamed: JP1.1 (NC), U1.86
unnamed: COM2.4, U1.130
unnamed: COM2.3, U1.129
unnamed: COM2.2, U1.128
unnamed: LED2.A, R31.2
unnamed: R31.1, U1.144
unnamed: J5.2, U1.1
unnamed: J5.4, U1.2
unnamed: J5.6, U1.3
unnamed: J5.3, U1.4
unnamed: J5.5, U1.5
unnamed: LED3.A, U1.101
unnamed: LED3.C, R32.2
unnamed: J7.8, U1.75
NAND_CS: IC5.1 (CS/), U1.32
NAND_HOLD: IC5.7 (HOLD/), U1.35
NAND_SCLK: IC5.6 (SCK), U1.34
NAND_SI: IC5.5 (SI), U1.33
NAND_SO: IC5.2 (SO), U1.31
NAND_WP: IC5.3 (WP/), U1.30
PROGRAM: R25.2, R29.1, U1.10, U1.13 (/PROGRAM)
RESET_N: C41.1, R28.1, S1.3 (S), S1.4 (S1), U1.36
SCLK: J6.3, U1.61
SCLK1: J9.3, U1.46
SYSCLK: IC2.8 (O), U1.92
VCCINT: C14.1, C15.1, C16.1, C17.1, C18.1, C19.1, R4.1, R5.1, TP2.1, U1.38 (VCORE), U1.47 (VCORE1), U1.63 (VCORE2), U1.117 (VCORE_5), U1.132 (VCORE_3), U1.143 (VCORE_4); also elsewhere on the board
VCC_PLL0: C21.1, R5.2, U1.109 (VCC_PLL)
VCC_PLL1: C20.1, R4.2, U1.37 (VCC_PLL1)

Notes on the sheet:
AL3S10LG144-Audio Processing Board

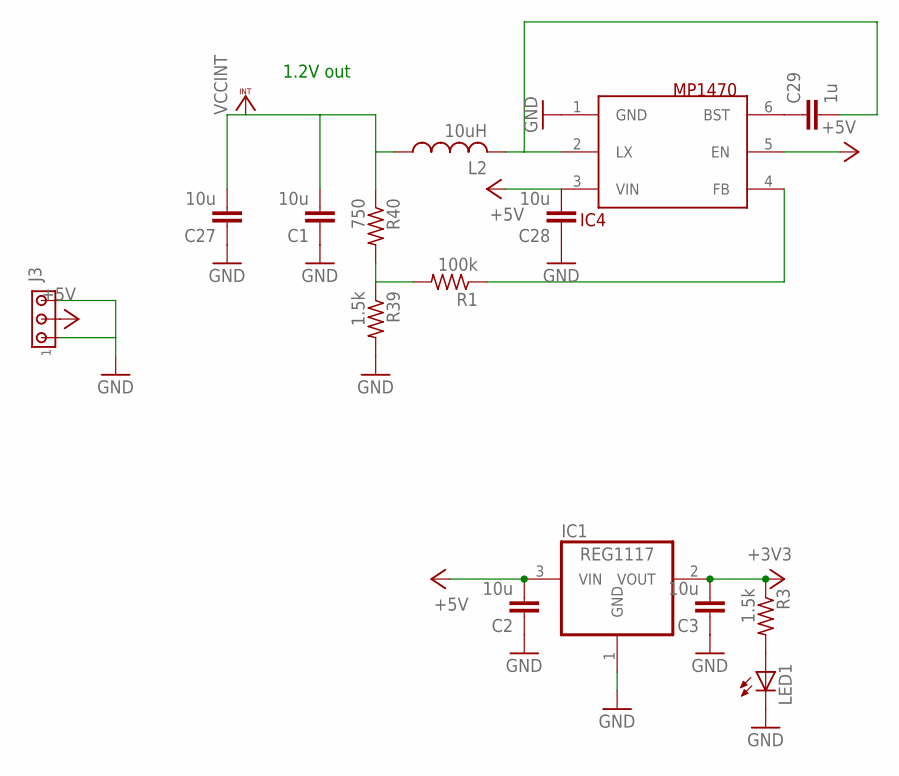
[picture p17: schematic al3lg.sch, sheet 2]

Parts:
C1, C2, C3, C27, C28: 10u; C0805
C29: 1u; C0805
IC1: REG1117; SOT223
IC4: MP1470; SOT23-6L
J3: MTA03-100; 10X03MTA
L2: 10uH; L4532P
LED1: LEDSML0805; SML0805
R1: 100k; R0805
R3, R39: 1.5k; R0805
R40: 750; R0805

Connections:
+3V3: C3.2, IC1.2 (VOUT), R3.1; also elsewhere on the board
+5V: C2.2, C28.2, IC1.3 (VIN), IC4.3 (VIN), IC4.5 (EN), J3.2; also elsewhere on the board
GND: C1.1, C2.1, C3.1, C27.1, C28.1, IC1.1 (GND), IC4.1 (GND), J3.1, J3.3, LED1.C, R39.2; also elsewhere on the board
unnamed: R1.2, R39.1, R40.2
unnamed: LED1.A, R3.2
unnamed: C29.2, IC4.2 (LX), L2.2
unnamed: C29.1, IC4.6 (BST)
unnamed: IC4.4 (FB), R1.1
VCCINT: C1.2, C27.2, L2.1, R40.1; also elsewhere on the board

Notes on the sheet:
1.2V out

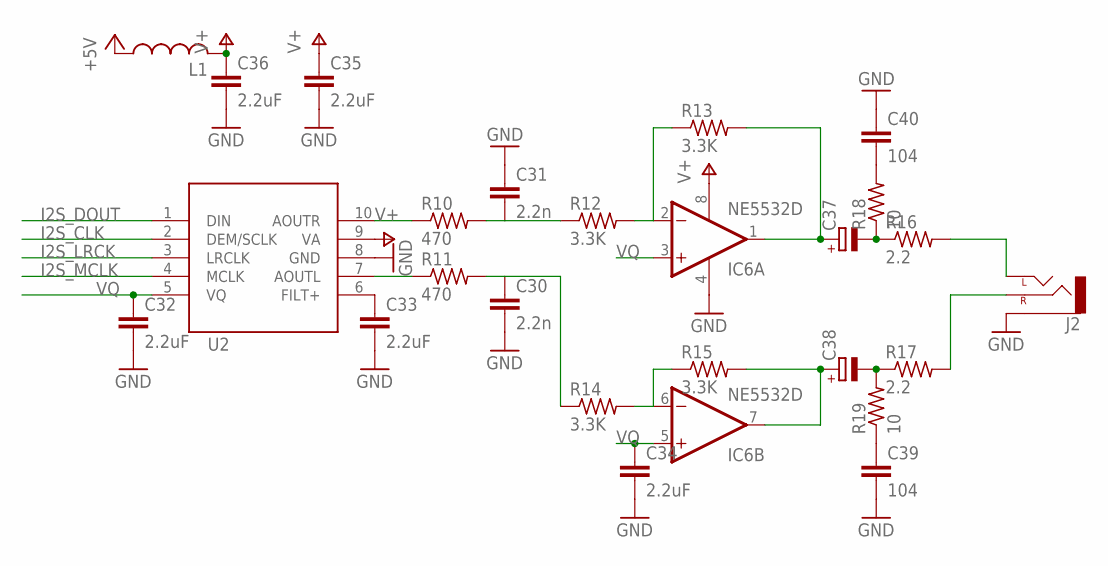
[picture p18: schematic al3lg.sch, sheet 3]

Parts:
C30, C31: 2.2n; C0805
C32, C33, C34, C35, C36: 2.2uF; C0805
C37, C38: CPOL-EUE2.5-7; E2,5-7
C39, C40: 104; C0805
IC6: NE5532D; SO08
J2: AUDIO-JACKPTH; AUDIO-JACK
L1: L-USL4532P; L4532P
R10, R11: 470; R0805
R12, R13, R14, R15: 3.3K; R0805
R16, R17: 2.2; R0805
R18, R19: 10; R0805
U2: CS4344; TSSOP10

Connections:
+5V: L1.1; also elsewhere on the board
GND: C30.2, C31.1, C32.2, C33.2, C34.2, C35.2, C36.2, C39.2, C40.1, IC6.4 (V-), J2.SLEEVE, U2.8 (GND); also elsewhere on the board
I2S_CLK: U2.2 (DEM/SCLK); also elsewhere on the board
I2S_DOUT: U2.1 (DIN); also elsewhere on the board
I2S_LRCK: U2.3 (LRCLK); also elsewhere on the board
I2S_MCLK: U2.4 (MCLK); also elsewhere on the board
unnamed: R11.1, U2.7 (AOUTL)
unnamed: C30.1, R11.2, R14.1
unnamed: R10.1, U2.10 (AOUTR)
unnamed: C31.2, R10.2, R12.1
unnamed: IC6.2 (-IN), R12.2, R13.1
unnamed: C37.+, IC6.1 (OUT), R13.2
unnamed: IC6.6 (-IN), R14.2, R15.1
unnamed: C38.+, IC6.7 (OUT), R15.2
unnamed: C33.1, U2.6 (FILT+)
unnamed: C37.-, R16.1, R18.1
unnamed: C38.-, R17.1, R19.2
unnamed: J2.TIP (LEFT), R16.2
unnamed: J2.RING (RIGHT), R17.2
unnamed: C39.1, R19.1
unnamed: C40.2, R18.2
V+: C35.1, C36.1, IC6.8 (V+), L1.2, U2.9 (VA)
VQ: C32.1, C34.1, IC6.3 (+IN), IC6.5 (+IN), U2.5 (VQ)

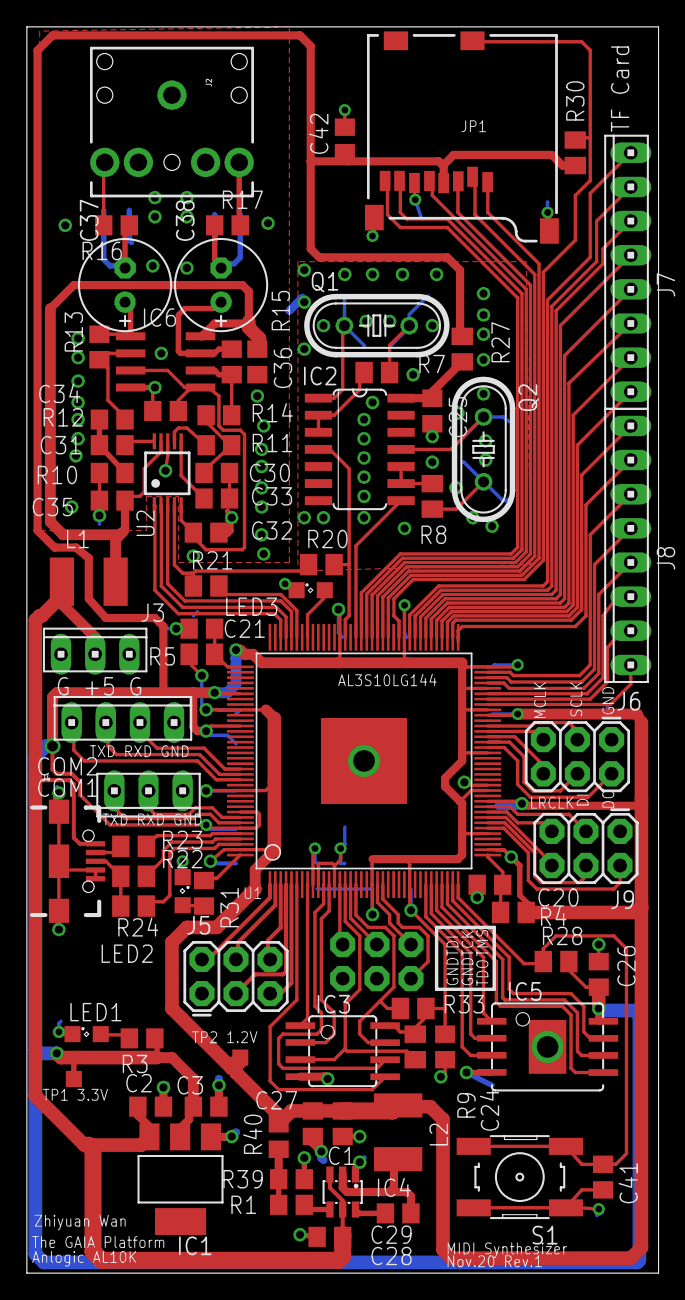
[picture p19: board al3lg.brd from above]

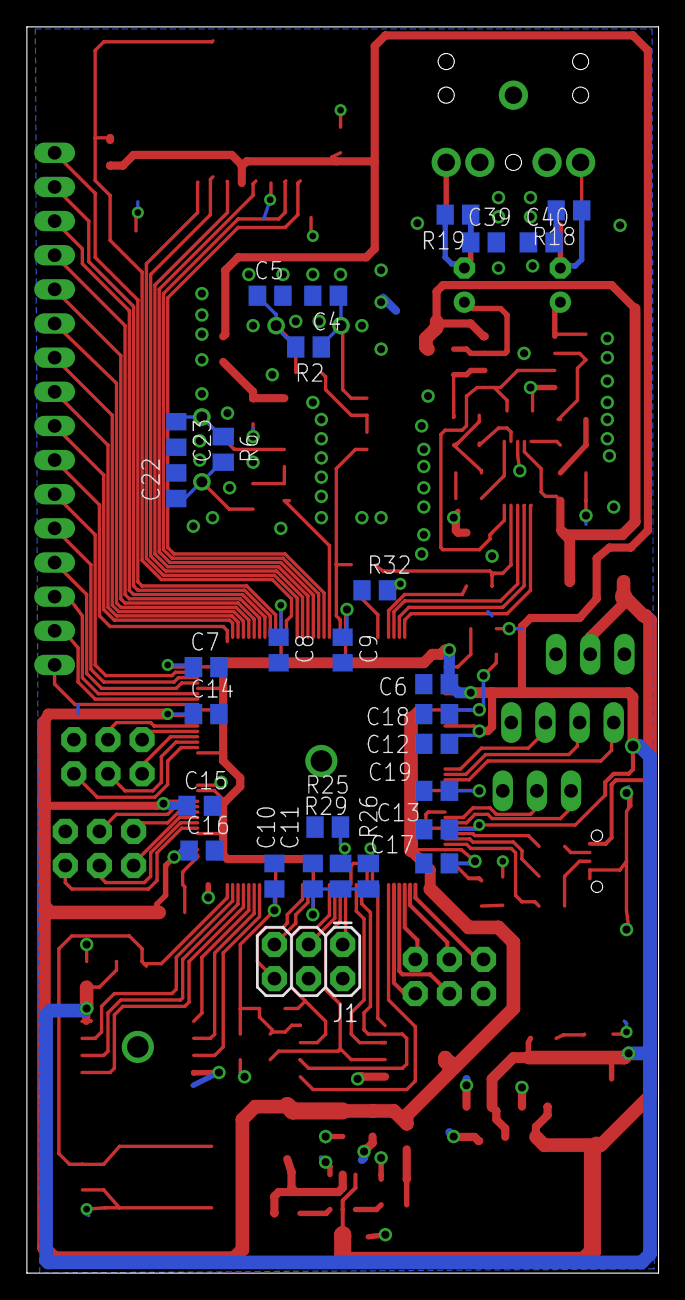
[picture p20: board al3lg.brd from below]

Board: 2 copper layers, 47.0 x 92.7 mm, 107 parts (29 on the bottom side), 113 nets.
